dheeraj9932/Individually_actuated_all_terrain_robot/arm ansys.tif

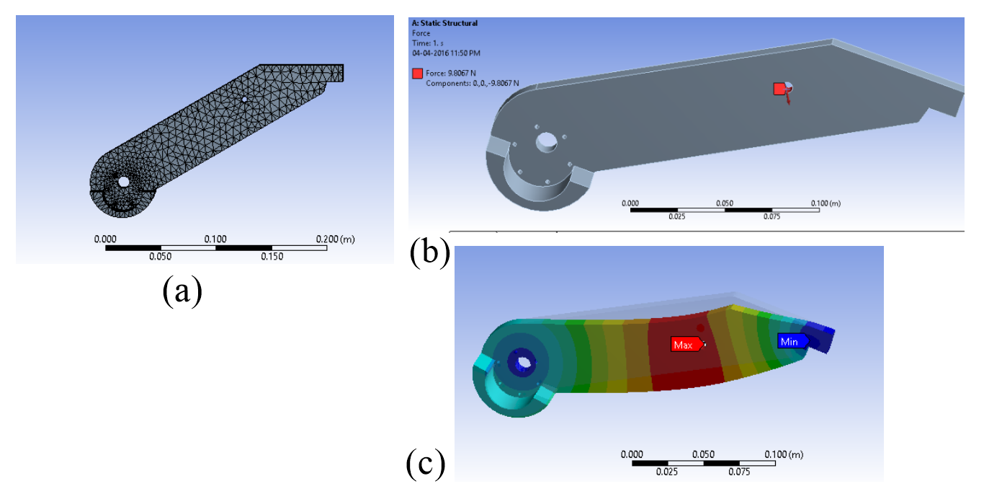
arm ansys.tif
