dheeraj9932/Individually_actuated_all_terrain_robot/355f3d01-9d09-4b83-87e9-49837edca5f1.jpg

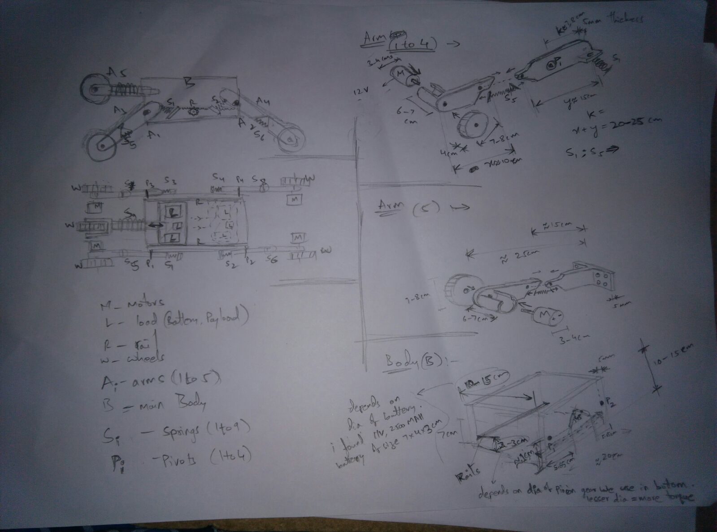
355f3d01-9d09-4b83-87e9-49837edca5f1.jpg
