dheeraj9932/Individually_actuated_all_terrain_robot/README.md

# Individually_actuated_all_terrain_robot
