dheeraj9932/Individually_actuated_all_terrain_robot/Report/6 Table of Contents.docx

TABLE OF CONTENTS

ACKNOWLEDGEMENTS

ABSTRACT

TABLE OF CONTENTS

LIST OF FIGURES

LIST OF TABLES

LIST OF ABBREVIATIONS

1 INTRODUCTION
  1.1 Locomotion for Rough Terrain
  1.2 Additive Manufacturing (3D Printing)
2 LITERATURE REVIEW AND PROBLEM IDENTIFICATION
  2.1 Problem Identification
  2.2 Objectives of Project
  2.3 Types of All-Terrain Robots
    2.3.1 Legged Robots
    2.3.2 Wheeled Robots
    2.3.3 Tracked Robots
    2.3.4 Re-Configurable Robots
  2.4 Comparison Factors
    2.4.1 Terrain Capabilities
    2.4.2 Payloads
    2.4.3 Stability
    2.4.4 Speed
    2.4.5 Complexity
  2.5 Comparison of Various Types of Locomotion
  2.6 Types of Additive Manufacturing Techniques
    2.6.1 Stereo-Lithography - SLA
    2.6.2 Multi-Jet Modelling – MJM
    2.6.3 Selective Laser Sintering - SLS
    2.6.4 Fused Deposition Modelling – FDM
  2.7 Problem Identification
3 METHODOLOGY
  3.1 Methodology
4 IMPLEMENTATION
  4.1 Obstacle Negotiating Strategies
    4.1.1 Types of Obstacles
    4.1.2 Obstacle Negotiation
    4.1.3 Proposed Performance Specifications
  4.2 Development of IAR 1 and IAR 2
    4.2.1 Performance Comparison of IAR 1 and IAR 2
  4.3 Final Design and Prototype – IAR 3
    4.3.1 Design of Vehicle Body
    4.3.2 Design of Vehicle Arms
    4.3.3 Performance of the Vehicle
5 RESULT ANALYSIS, CONCLUSION & FUTURE WORK

REFERENCES

APPENDICES
