dheeraj9932/Individually_actuated_all_terrain_robot/body with dims.jpg

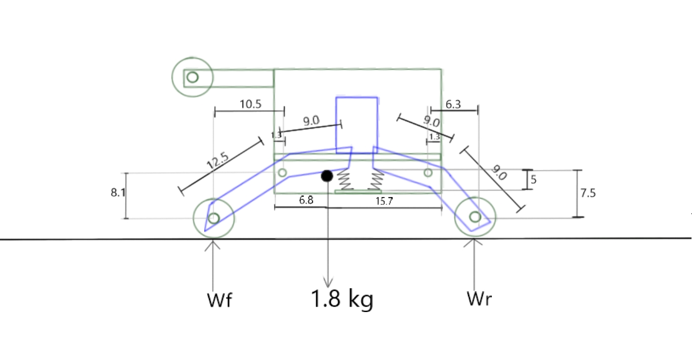
body with dims.jpg
