dheeraj9932/Individually_actuated_all_terrain_robot/Models/fin/BOX.png

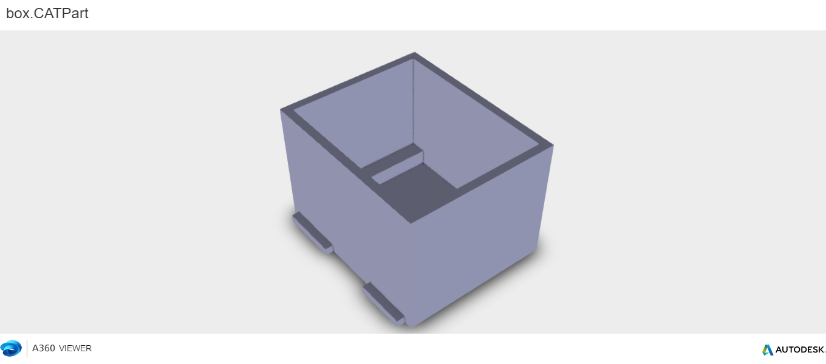
Models/fin/BOX.png
