dheeraj9932/Individually_actuated_all_terrain_robot/Models/fin/Nose Front.png

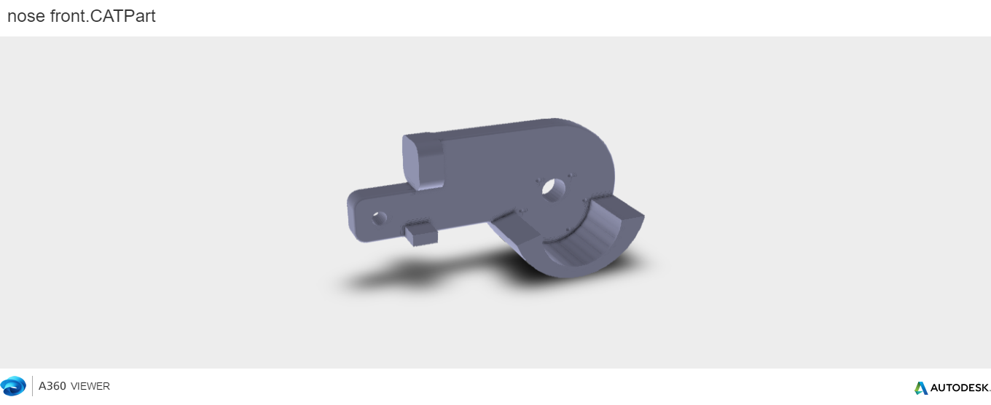
Models/fin/Nose Front.png
