dheeraj9932/Individually_actuated_all_terrain_robot/Models/fin/Screenshot (1).png

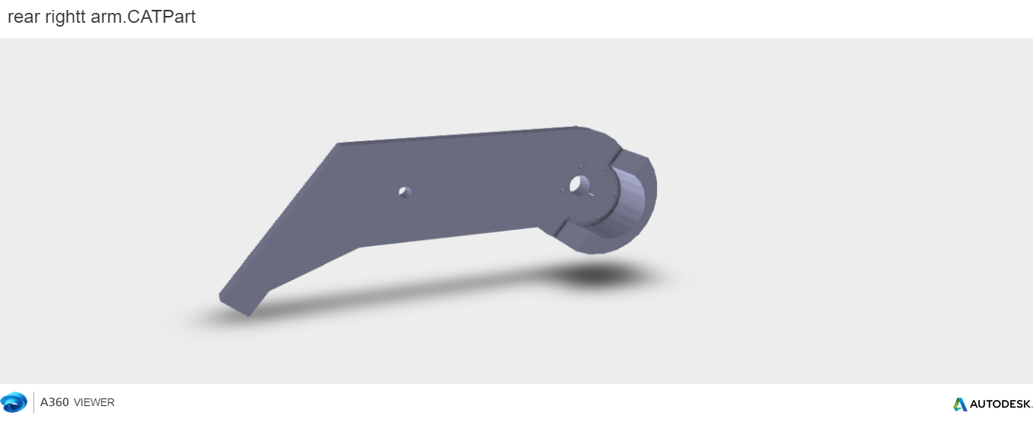
Models/fin/Screenshot (1).png
