dheeraj9932/Individually_actuated_all_terrain_robot/Models/fin/Screenshot.png

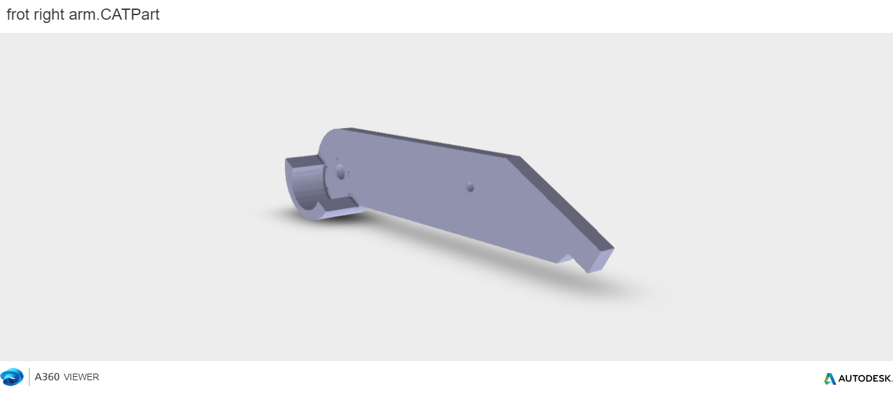
Models/fin/Screenshot.png
