dheeraj9932/Individually_actuated_all_terrain_robot/Models/IAR 2/bot/et97nmx.png

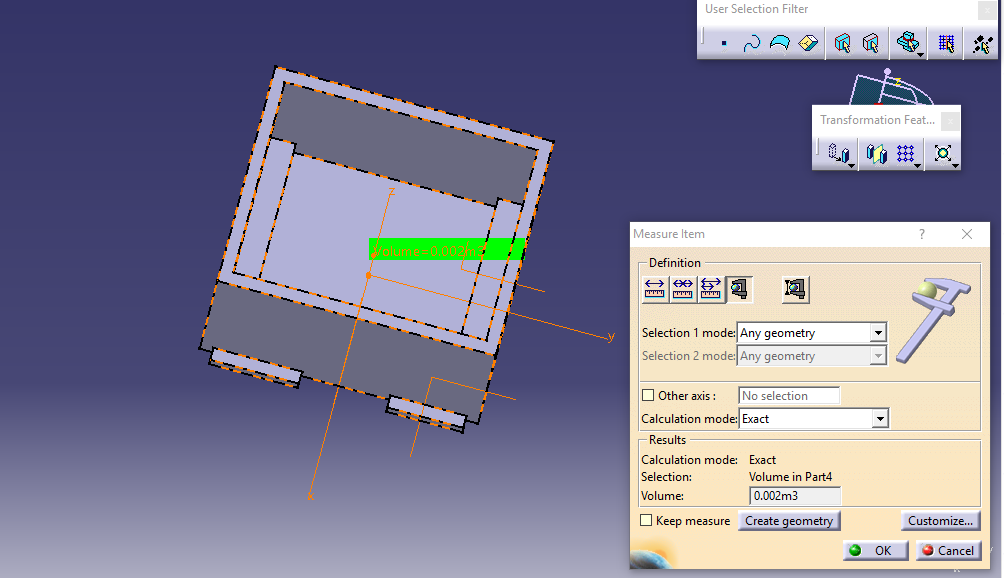
Models/IAR 2/bot/et97nmx.png
