dheeraj9932/Individually_actuated_all_terrain_robot/Models/IAR 2/bot/eXSL1E1.png

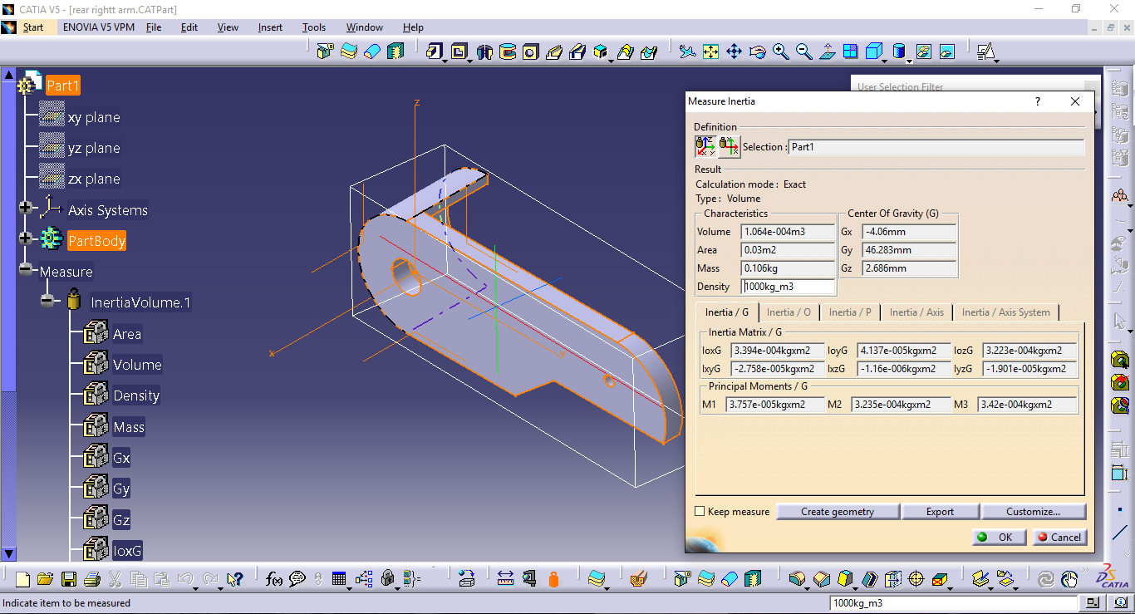
Models/IAR 2/bot/eXSL1E1.png
