dheeraj9932/Individually_actuated_all_terrain_robot/Models/IAR 2/bot/peZnfe8.png

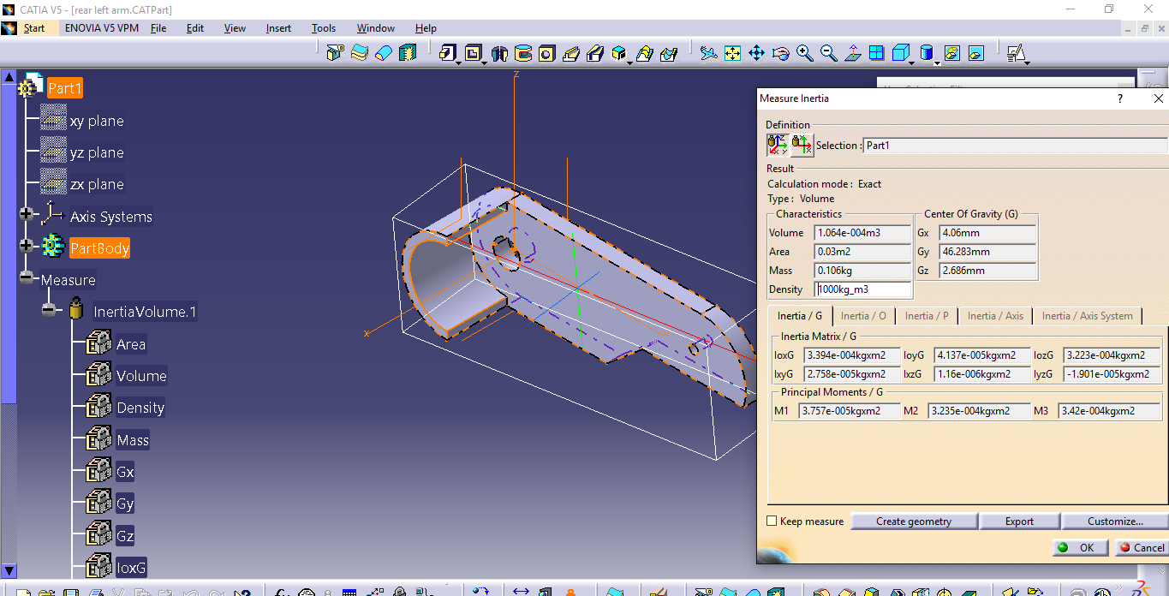
Models/IAR 2/bot/peZnfe8.png
