dheeraj9932/Individually_actuated_all_terrain_robot/obstacle negotiation collage correct.jpg

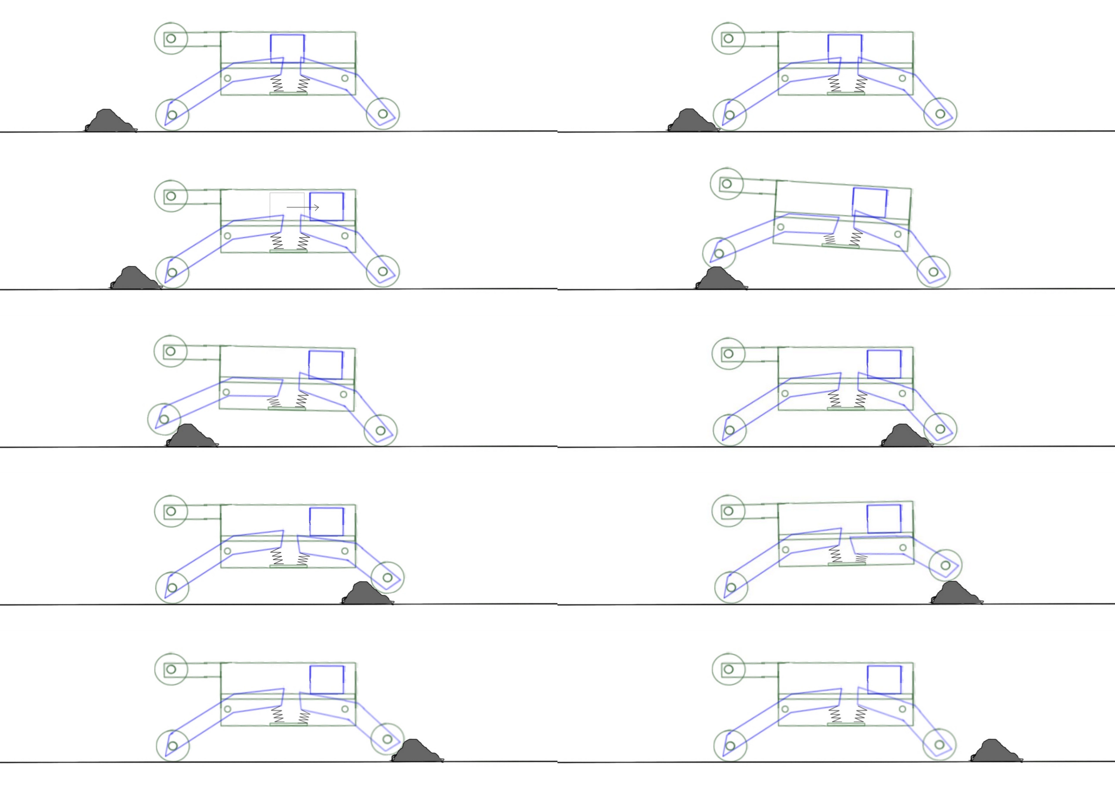
obstacle negotiation collage correct.jpg
