dheeraj9932/Individually_actuated_all_terrain_robot/(list of files, cad)

Other CAD files:
Models/IAR 2/bot/box.CATPart
Models/IAR 2/bot/frot leftt arm.CATPart
Models/IAR 2/bot/frot right arm.CATPart
Models/IAR 2/bot/nose ass.CATProduct
Models/IAR 2/bot/nose front.CATPart
Models/IAR 2/bot/nose rear.CATPart
Models/IAR 2/bot/rear left arm.CATPart
Models/IAR 2/bot/rear rightt arm.CATPart
Models/fin/box.CATPart
Models/fin/frot leftt arm.CATPart
Models/fin/frot right arm.CATPart
Models/fin/motor hub.CATPart
Models/fin/nose front.CATPart
Models/fin/nose rear.CATPart
Models/fin/rear left arm.CATPart
Models/fin/rear rightt arm.CATPart
