dheeraj9932/Individually_actuated_all_terrain_robot/Models/fin/nose front.pdf

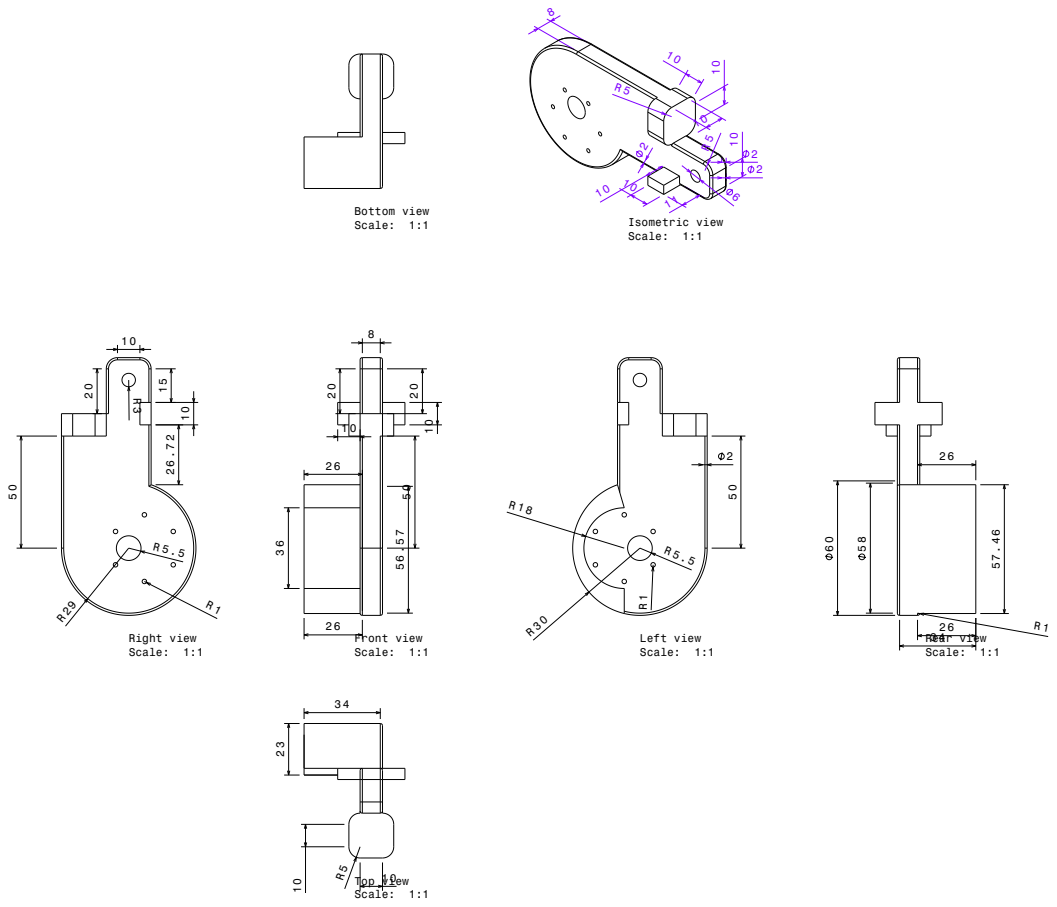
[picture p17: page 1]
Front view; Scale: 1:1 50 56.57; Rear view; Scale: 1:157.46; Top view Scale: 1:1; Bottom view Scale: 1:1; Left view Scale: 1:1; Right view Scale: 1:1; Isometric view Scale: 1:1
