dheeraj9932/Individually_actuated_all_terrain_robot/Models/fin/rear right arm.pdf

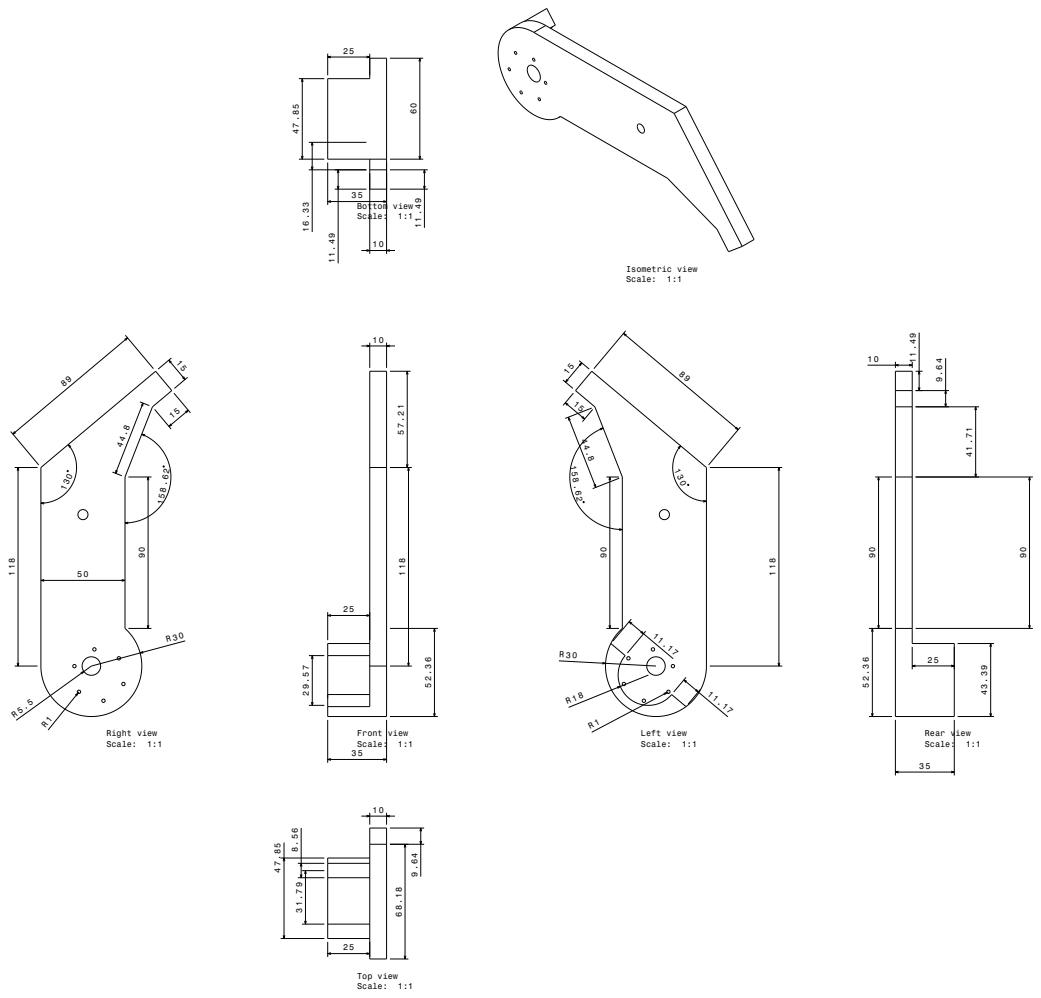
[picture p18: page 1]
Scale: 1:1; Rear view Scale: 1:1; Top view; Scale: 1:1 68.18; Bottom view Scale: 1:1; Left view Scale: 1:1; Right view Scale: 1:1; Isometric view Scale: 1:1
